Ksisu/philips_led_bulb/philips_led_bulb.pdf

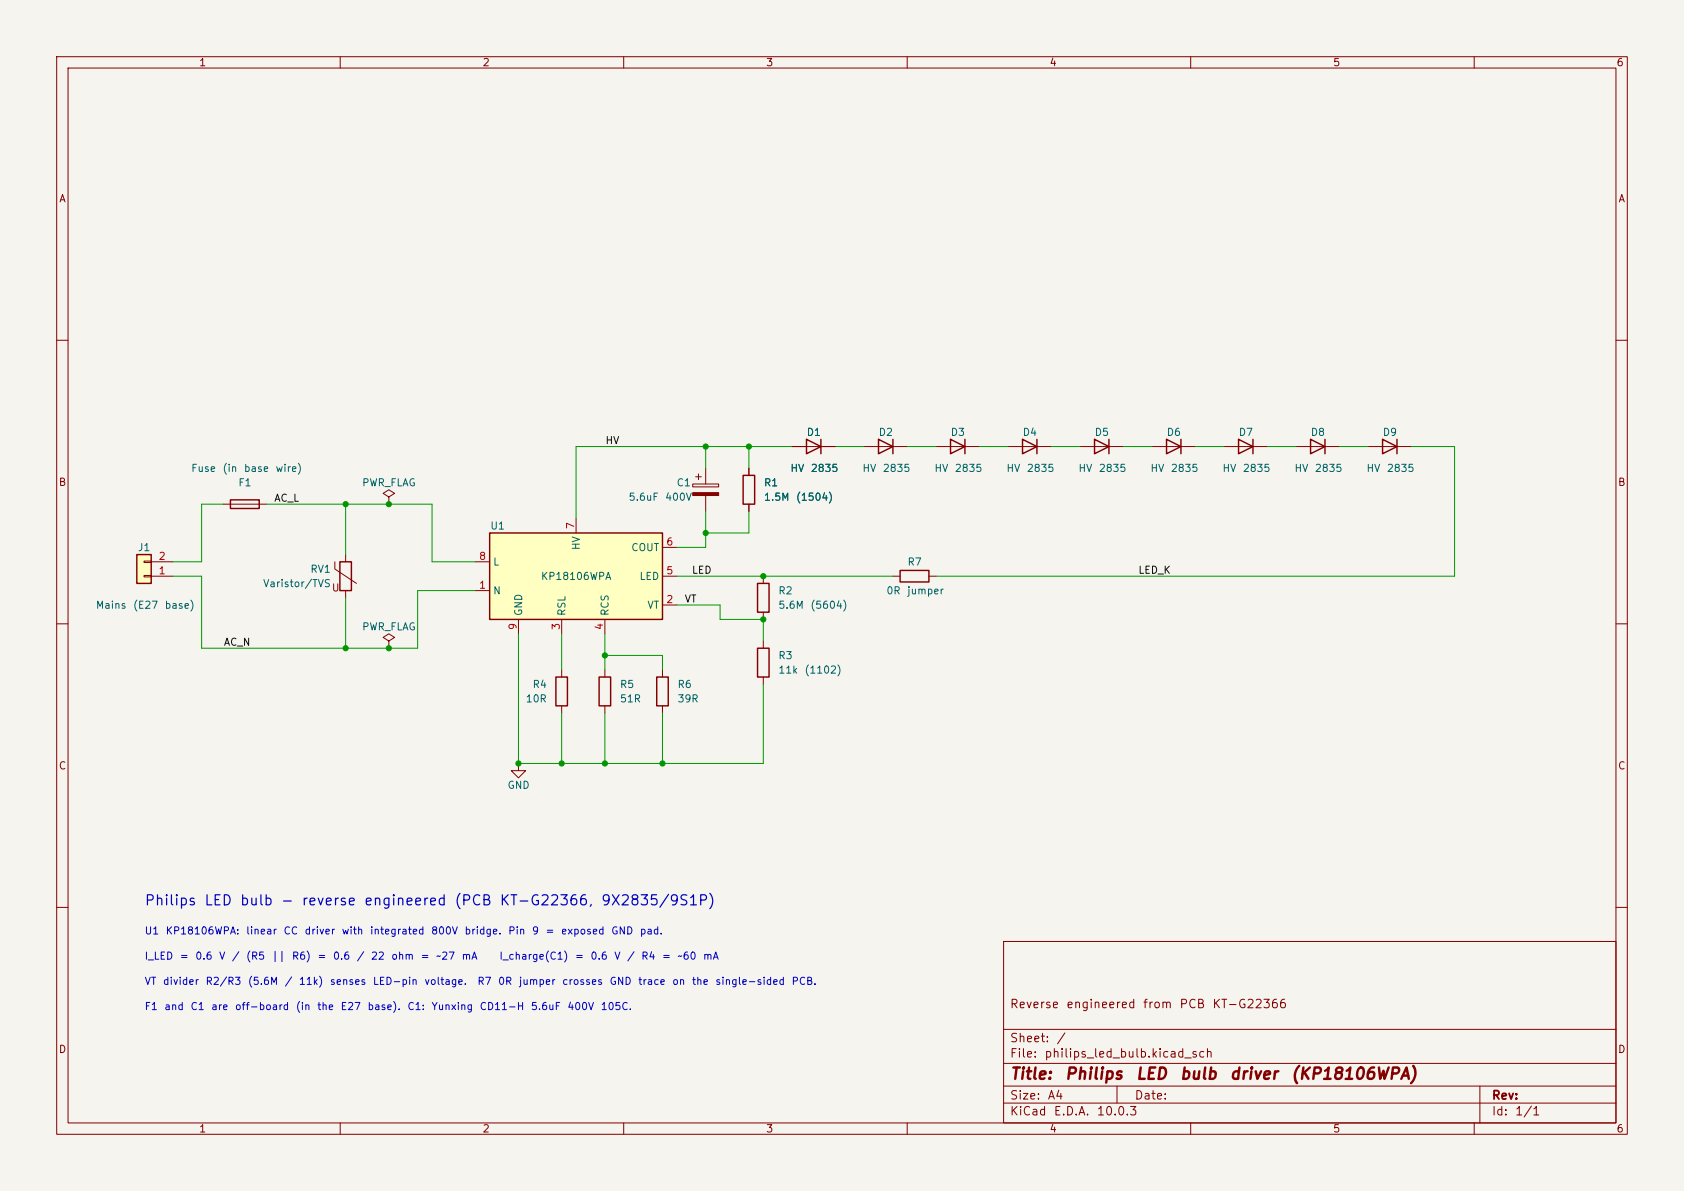
[picture p1: page 1]

VT VT divider R2/R3 (5.6M / 11k) senses LED-pin voltage. R7 0R jumper crosses GND trace on the single-sided PCB. F1 and C1 are off-board (in the E27 base). C1: Yunxing CD11-H 5.6uF 400V 105C. Philips LED bulb - reverse engineered (PCB KT-G22366, 9X2835/9S1P) U1 KP18106WPA: linear CC driver with integrated 800V bridge. Pin 9 = exposed GND pad.

Reverse engineered from PCB KT-G22366

Sheet: /
File: philips_led_bulb.kicad_sch
Title: Philips LED bulb driver (KP18106WPA)

Size: A4 | Rev:
KiCad E.D.A. 10.0.3 | Id: 1/1
