Ksisu/philips_led_bulb/philips_led_bulb.kicad_sch

## KiCad design philips_led_bulb.kicad_sch (2026-10-27, an earlier design)

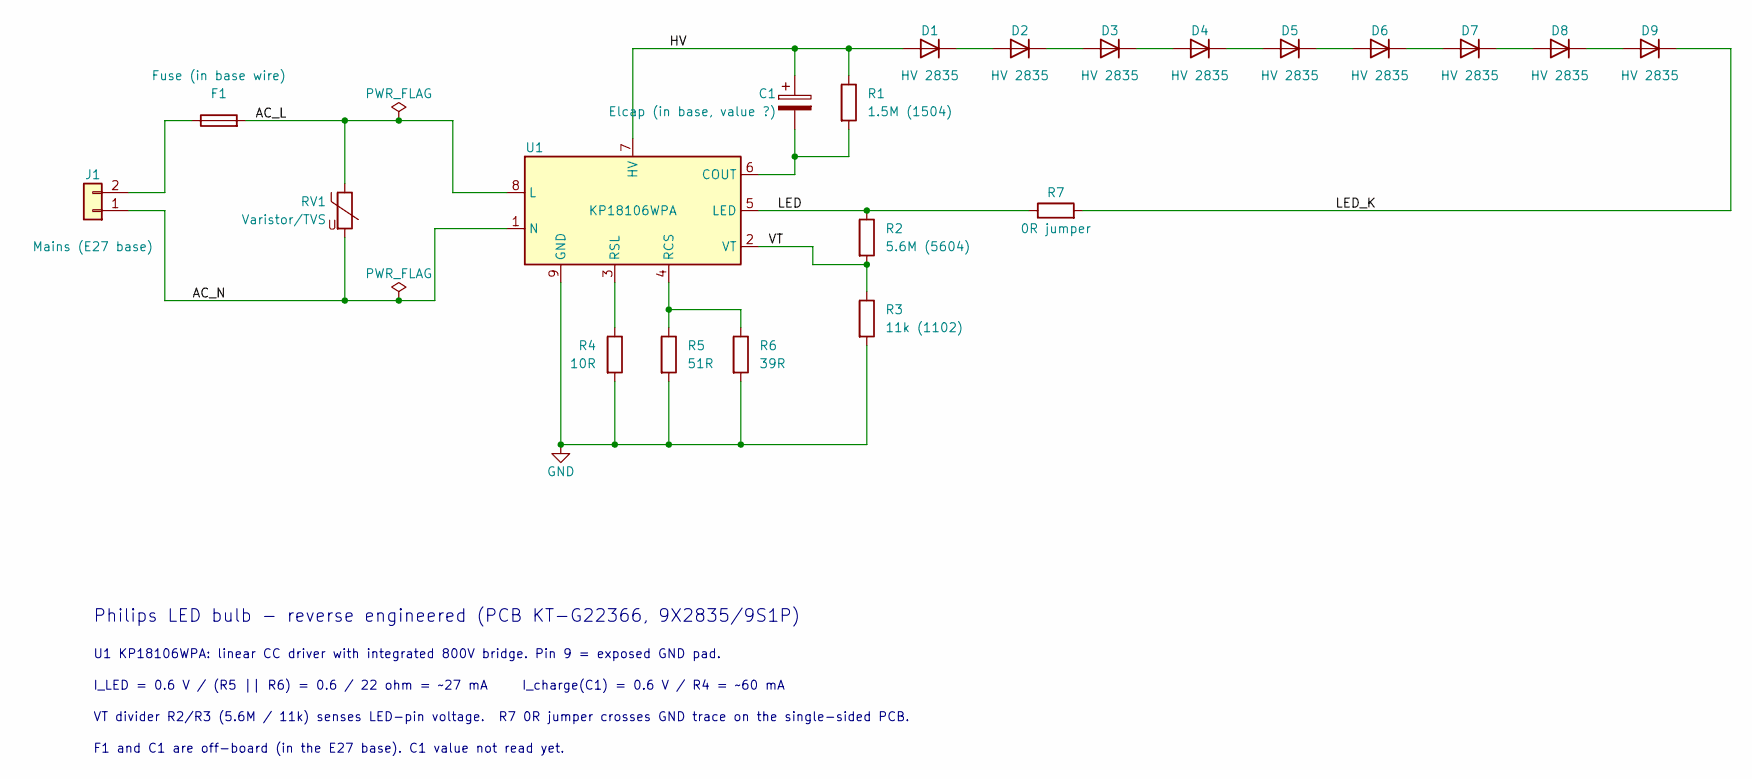
[picture p2: schematic philips_led_bulb.kicad_sch]

Parts:
C1: Elcap (in base, value ?)
D1, D2, D3, D4, D5, D6, D7, D8, D9: HV 2835
F1: Fuse (in base wire)
J1: Mains (E27 base)
R1: 1.5M (1504)
R2: 5.6M (5604)
R3: 11k (1102)
R4: 10R
R5: 51R
R6: 39R
R7: 0R jumper
RV1: Varistor/TVS
U1: KP18106WPA

Connections:
AC_L: F1.2, RV1.1, U1.8 (L)
AC_N: J1.1, RV1.2, U1.1 (N)
GND: R3.2, R4.2, R5.2, R6.2, U1.9 (GND)
HV: C1.1, D1.2 (A), R1.1, U1.7 (HV)
LED: R2.1, R7.1, U1.5 (LED)
LED_K: D9.1 (K), R7.2
unnamed: C1.2, R1.2, U1.6 (COUT)
unnamed: D1.1 (K), D2.2 (A)
unnamed: D2.1 (K), D3.2 (A)
unnamed: D3.1 (K), D4.2 (A)
unnamed: D4.1 (K), D5.2 (A)
unnamed: D5.1 (K), D6.2 (A)
unnamed: D6.1 (K), D7.2 (A)
unnamed: D7.1 (K), D8.2 (A)
unnamed: D8.1 (K), D9.2 (A)
unnamed: F1.1, J1.2
unnamed: R4.1, U1.3 (RSL)
unnamed: R5.1, R6.1, U1.4 (RCS)
VT: R2.2, R3.1, U1.2 (VT)

Notes on the sheet:
I_LED = 0.6 V / (R5 || R6) = 0.6 / 22 ohm = ~27 mA I_charge(C1) = 0.6 V / R4 = ~60 mA
U1 KP18106WPA: linear CC driver with integrated 800V bridge. Pin 9 = exposed GND pad.
VT divider R2/R3 (5.6M / 11k) senses LED-pin voltage. R7 0R jumper crosses GND trace on the single-sided PCB.
F1 and C1 are off-board (in the E27 base). C1 value not read yet.
Philips LED bulb - reverse engineered (PCB KT-G22366, 9X2835/9S1P)
