Ksisu/philips_led_bulb/(commit log)

2026-10-23 Reverse-engineered Philips LED bulb driver schematic (KP18106WPA)
    Claude-Session: https://claude.ai/code/session_01DkF4XRCCz81Qun3gAk33U7
    [philips_led_bulb.kicad_pcb, philips_led_bulb.kicad_sch]
2026-10-23 Add README explaining the circuit
    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
2026-10-27 Add C1 value: 5.6uF 400V (Yunxing CD11-H)
    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
    [philips_led_bulb.kicad_sch]
